coon42/FloppyOrgel/README.md

# FloppyOrgel
Collection of Software for the Floppy Orgel
