coon42/FloppyOrgel/Arduino/pcb/footprints/atmega328p-32tqfp.png

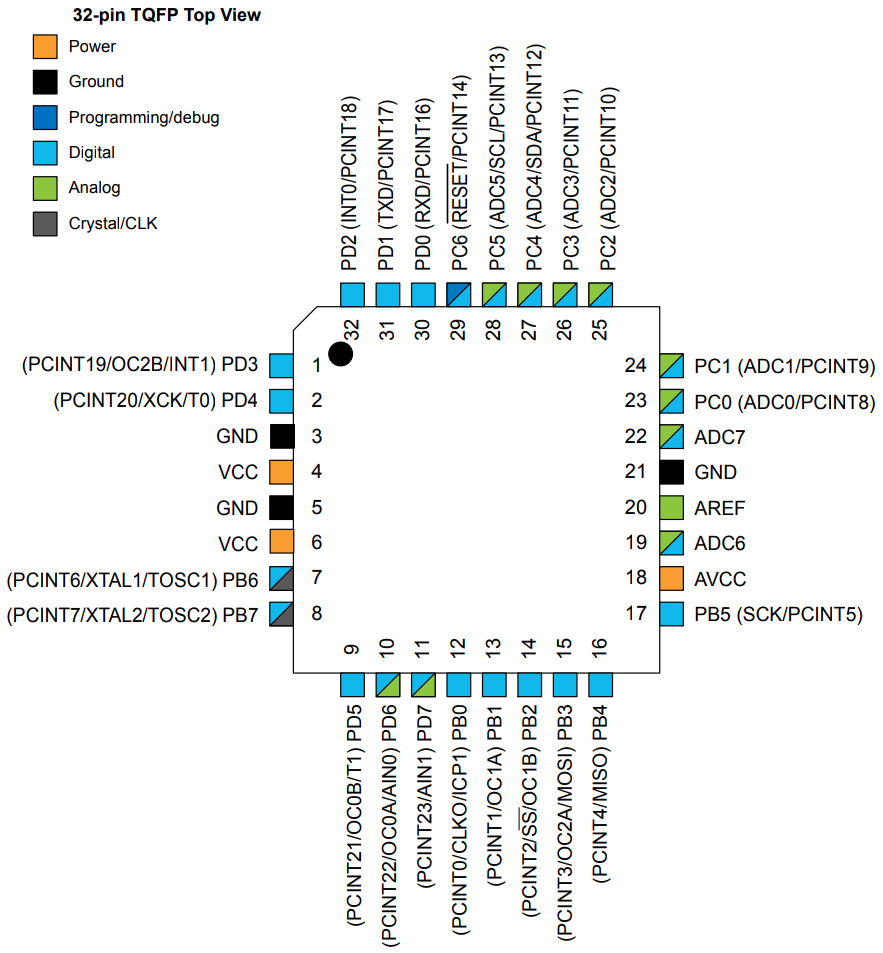
Arduino/pcb/footprints/atmega328p-32tqfp.png
