coon42/FloppyOrgel/(list of files, drawings)

Other design files:
Arduino/old_pcb/floppy_m0dule.PcbDoc
Arduino/old_pcb/floppy_m0dule.PcbLib
Arduino/old_pcb/floppy_m0dule.SchDoc
Arduino/old_pcb/floppy_m0dule.SchLib
Arduino/old_pcb/footprints.PcbLib
Arduino/old_pcb/open_step.PcbLib
Arduino/old_pcb/PCB_floppy_m0dule.PrjPCB
Arduino/pcb/floppy_m0dule.PcbDoc
Arduino/pcb/floppy_m0dule.PcbLib
Arduino/pcb/floppy_m0dule.SchDoc
Arduino/pcb/floppy_m0dule.SchLib
Arduino/pcb/footprints.PcbLib
Arduino/pcb/open_step.PcbLib
Arduino/pcb/PCB_floppy_m0dule.PrjPCB
