coon42/FloppyOrgel/Arduino/pcb/floppyorgel.kicad_pcb

## KiCad design Arduino/pcb/floppyorgel.kicad_pcb (2020-02-22)

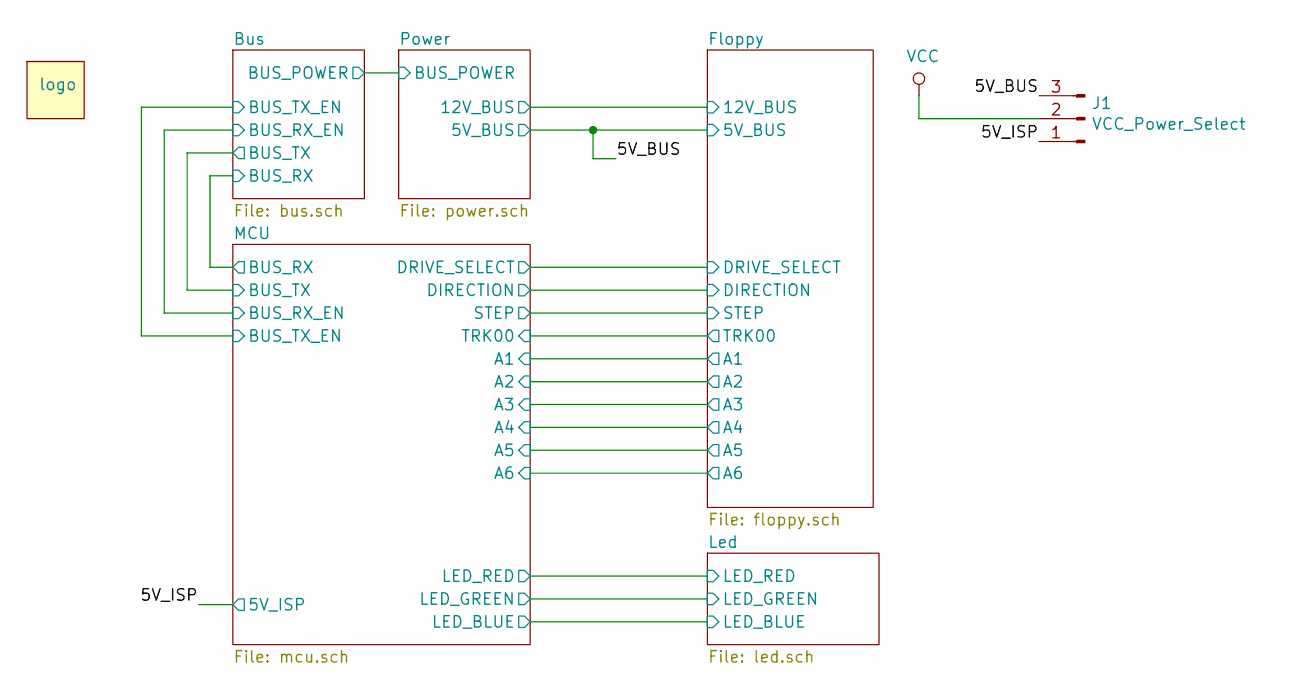
[picture p2: schematic floppyorgel.sch, Floppy Orgel]

Parts:
J1: VCC_Power_Select; switch_mmp122-r
L1: logo

Connections:
/5V_BUS: J1.3; also elsewhere on the board
/5V_ISP: J1.1; also elsewhere on the board
VCC: J1.2; also elsewhere on the board

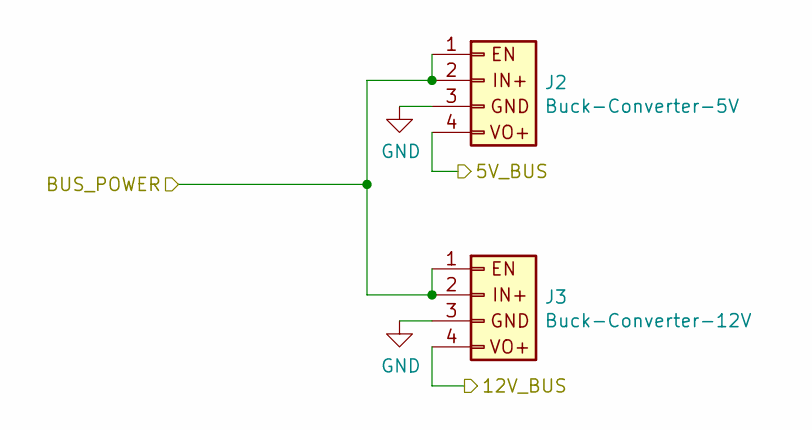
[picture p3: schematic power.sch]

Parts:
J2: Buck-Converter-5V; PinSocket_1x04_P2.54mm_Vertical
J3: Buck-Converter-12V; PinSocket_1x04_P2.54mm_Vertical

Connections:
/5V_BUS: J2.4; also elsewhere on the board
/Bus/BUS_POWER: J2.1, J2.2, J3.1, J3.2; also elsewhere on the board
/Floppy/12V_BUS: J3.4; also elsewhere on the board
GND: J2.3, J3.3; also elsewhere on the board

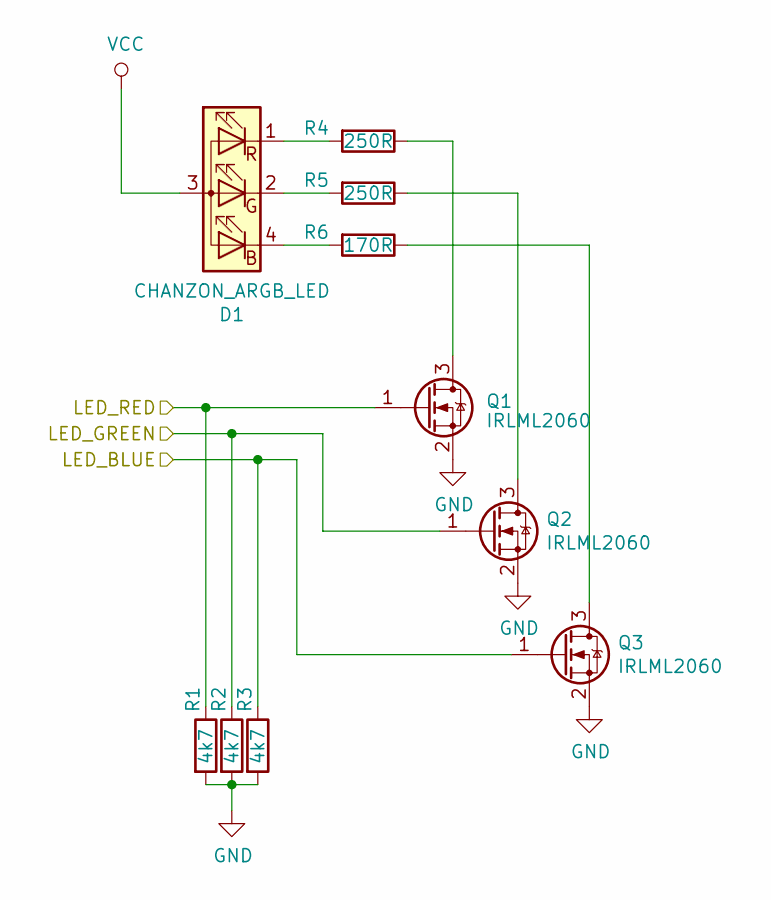
[picture p4: schematic led.sch]

Parts:
D1: CHANZON_ARGB_LED; rgb_led_0805_2012Metric
Q1, Q2, Q3: IRLML2060; SOT-23
R1, R2, R3: 4k7; R_0805_2012Metric
R4, R5: 250R; R_0805_2012Metric
R6: 170R; R_0805_2012Metric

Connections:
/Led/LED_BLUE: Q3.1 (G), R3.1; also elsewhere on the board
/Led/LED_GREEN: Q2.1 (G), R2.1; also elsewhere on the board
/Led/LED_RED: Q1.1 (G), R1.1; also elsewhere on the board
GND: Q1.2 (S), Q2.2 (S), Q3.2 (S), R1.2, R2.2, R3.2; also elsewhere on the board
unnamed: D1.1 (RK), R4.2
unnamed: D1.2 (GK), R5.2
unnamed: D1.4 (BK), R6.2
unnamed: Q1.3 (D), R4.1
unnamed: Q2.3 (D), R5.1
unnamed: Q3.3 (D), R6.1
VCC: D1.3 (COM); also elsewhere on the board

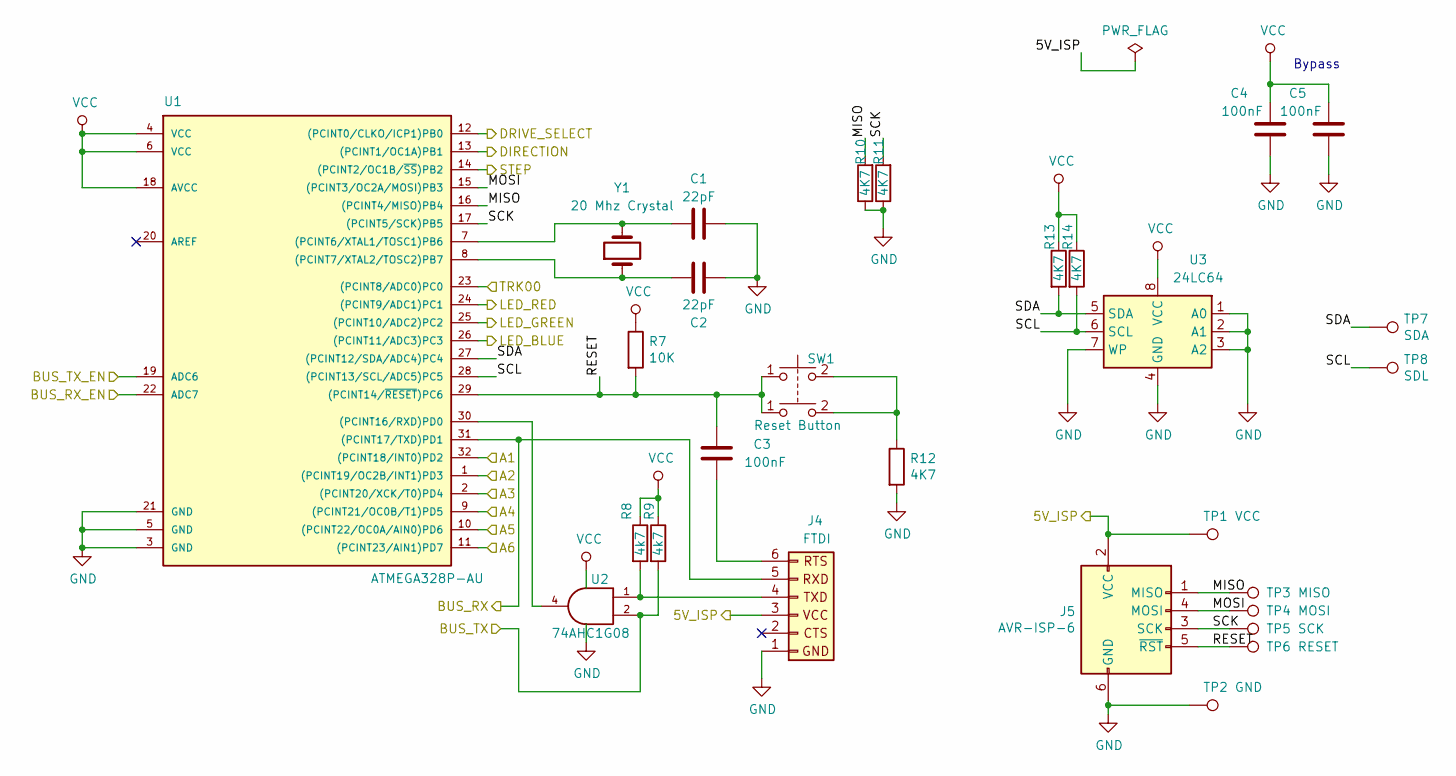
[picture p5: schematic mcu.sch]

Parts:
C1, C2: 22pF; C_0805_2012Metric
C3, C4, C5: 100nF; C_0805_2012Metric
J4: FTDI; PinHeader_1x06_P2.54mm_Vertical
J5: AVR-ISP-6; PinHeader_2x03_P2.54mm_Vertical
R7: 10K; R_0805_2012Metric
R8, R9: 4k7; R_0805_2012Metric
R10, R11, R12, R13, R14: 4K7; R_0805_2012Metric
SW1: Reset Button; SW_PUSH_6mm
TP1: VCC; TestPoint_Pad_D1.0mm
TP2: GND; TestPoint_Pad_D1.0mm
TP3: MISO; TestPoint_Pad_D1.0mm
TP4: MOSI; TestPoint_Pad_D1.0mm
TP5: SCK; TestPoint_Pad_D1.0mm
TP6: RESET; TestPoint_Pad_D1.0mm
TP7: SDA; TestPoint_Pad_D1.0mm
TP8: SDL; TestPoint_Pad_D1.0mm
U1: ATMEGA328P-AU; LQFP-32_7x7mm_P0.8mm
U2: 74AHC1G08; SOT-23-5
U3: 24LC64; TSSOP-8_4.4x3mm_P0.65mm
Y1: 20 Mhz Crystal; Crystal_HC49-4H_Vertical

Connections:
/5V_ISP: J4.3 (VCC), J5.2 (VCC), TP1.1; also elsewhere on the board
/Bus/BUS_RX: J4.5 (Receive), U1.31 ((PCINT17/TXD)PD1); also elsewhere on the board
/Bus/BUS_RX_EN: U1.22 (ADC7); also elsewhere on the board
/Bus/BUS_TX: R9.2, U2.2; also elsewhere on the board
/Bus/BUS_TX_EN: U1.19 (ADC6); also elsewhere on the board
/Floppy/A1: U1.32 ((PCINT18/INT0)PD2); also elsewhere on the board
/Floppy/A2: U1.1 ((PCINT19/OC2B/INT1)PD3); also elsewhere on the board
/Floppy/A3: U1.2 ((PCINT20/XCK/T0)PD4); also elsewhere on the board
/Floppy/A4: U1.9 ((PCINT21/OC0B/T1)PD5); also elsewhere on the board
/Floppy/A5: U1.10 ((PCINT22/OC0A/AIN0)PD6); also elsewhere on the board
/Floppy/A6: U1.11 ((PCINT23/AIN1)PD7); also elsewhere on the board
/Floppy/DIRECTION: U1.13 ((PCINT1/OC1A)PB1); also elsewhere on the board
/Floppy/DRIVE_SELECT: U1.12 ((PCINT0/CLKO/ICP1)PB0); also elsewhere on the board
/Floppy/STEP: U1.14 ((PCINT2/OC1B/~SS~)PB2); also elsewhere on the board
/Floppy/TRK00: U1.23 ((PCINT8/ADC0)PC0); also elsewhere on the board
/Led/LED_BLUE: U1.26 ((PCINT11/ADC3)PC3); also elsewhere on the board
/Led/LED_GREEN: U1.25 ((PCINT10/ADC2)PC2); also elsewhere on the board
/Led/LED_RED: U1.24 ((PCINT9/ADC1)PC1); also elsewhere on the board
/MCU/MISO: J5.1 (MISO), R10.2, TP3.1, U1.16 ((PCINT4/MISO)PB4)
/MCU/MOSI: J5.4 (MOSI), TP4.1, U1.15 ((PCINT3/OC2A/MOSI)PB3)
/MCU/RESET: C3.1, J5.5 (~RST), R7.2, SW1.1, TP6.1, U1.29 ((PCINT14/~RESET~)PC6)
/MCU/SCK: J5.3 (SCK), R11.2, TP5.1, U1.17 ((PCINT5/SCK)PB5)
/MCU/SCL: R14.2, TP8.1, U1.28 ((PCINT13/SCL/ADC5)PC5), U3.6 (SCL)
/MCU/SDA: R13.2, TP7.1, U1.27 ((PCINT12/SDA/ADC4)PC4), U3.5 (SDA)
GND: C1.2, C2.1, C4.2, C5.2, J4.1 (Ground), J5.6 (GND), R10.1, R11.1, R12.2, TP2.1, U1.3 (GND), U1.5 (GND), U1.21 (GND), U2.3 (GND), U3.1 (A0), U3.2 (A1), U3.3 (A2), U3.4 (GND), U3.7 (WP); also elsewhere on the board
unnamed: C1.1, U1.7 ((PCINT6/XTAL1/TOSC1)PB6), Y1.2
unnamed: C2.2, U1.8 ((PCINT7/XTAL2/TOSC2)PB7), Y1.1
unnamed: C3.2, J4.6 (Ready_to_send)
unnamed: J4.4 (Transmit), R8.2, U2.1
unnamed: R12.1, SW1.2
unnamed: U1.30 ((PCINT16/RXD)PD0), U2.4
VCC: C4.1, C5.1, R7.1, R8.1, R9.1, R13.1, R14.1, U1.4 (VCC), U1.6 (VCC), U1.18 (AVCC), U2.5 (VCC), U3.8 (VCC); also elsewhere on the board

Notes on the sheet:
Bypass

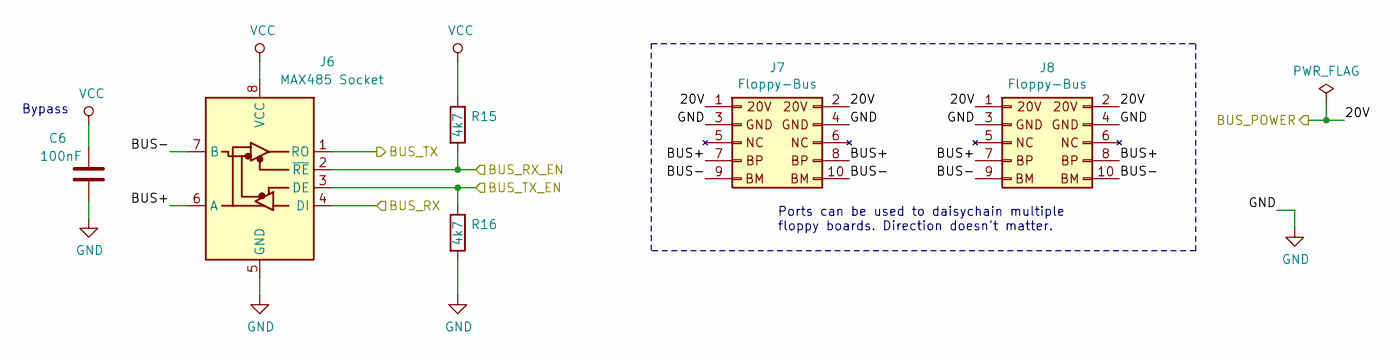
[picture p6: schematic bus.sch]

Parts:
C6: 100nF; C_0805_2012Metric
J6: MAX485 Socket; dil_8-300_socket
J7, J8: Floppy-Bus; Shrouded_Header_2x05_Pitch2.54mm
R15, R16: 4k7; R_0805_2012Metric

Connections:
/Bus/BUS+: J6.6 (A), J7.7 (BM), J7.8 (BM), J8.7 (BM), J8.8 (BM)
/Bus/BUS-: J6.7 (B), J7.9, J7.10, J8.9, J8.10
/Bus/BUS_POWER: J7.1 (20V), J7.2 (20V), J8.1 (20V), J8.2 (20V); also elsewhere on the board
/Bus/BUS_RX: J6.4 (DI); also elsewhere on the board
/Bus/BUS_RX_EN: J6.2 (~RE), R15.2; also elsewhere on the board
/Bus/BUS_TX: J6.1 (RO); also elsewhere on the board
/Bus/BUS_TX_EN: J6.3 (DE), R16.1; also elsewhere on the board
GND: C6.2, J6.5 (GND), J7.3 (GND), J7.4 (GND), J8.3 (GND), J8.4 (GND), R16.2; also elsewhere on the board
VCC: C6.1, J6.8 (VCC), R15.1; also elsewhere on the board

Notes on the sheet:
Bypass
Ports can be used to daisychain multiple floppy boards. Direction doesn't matter.

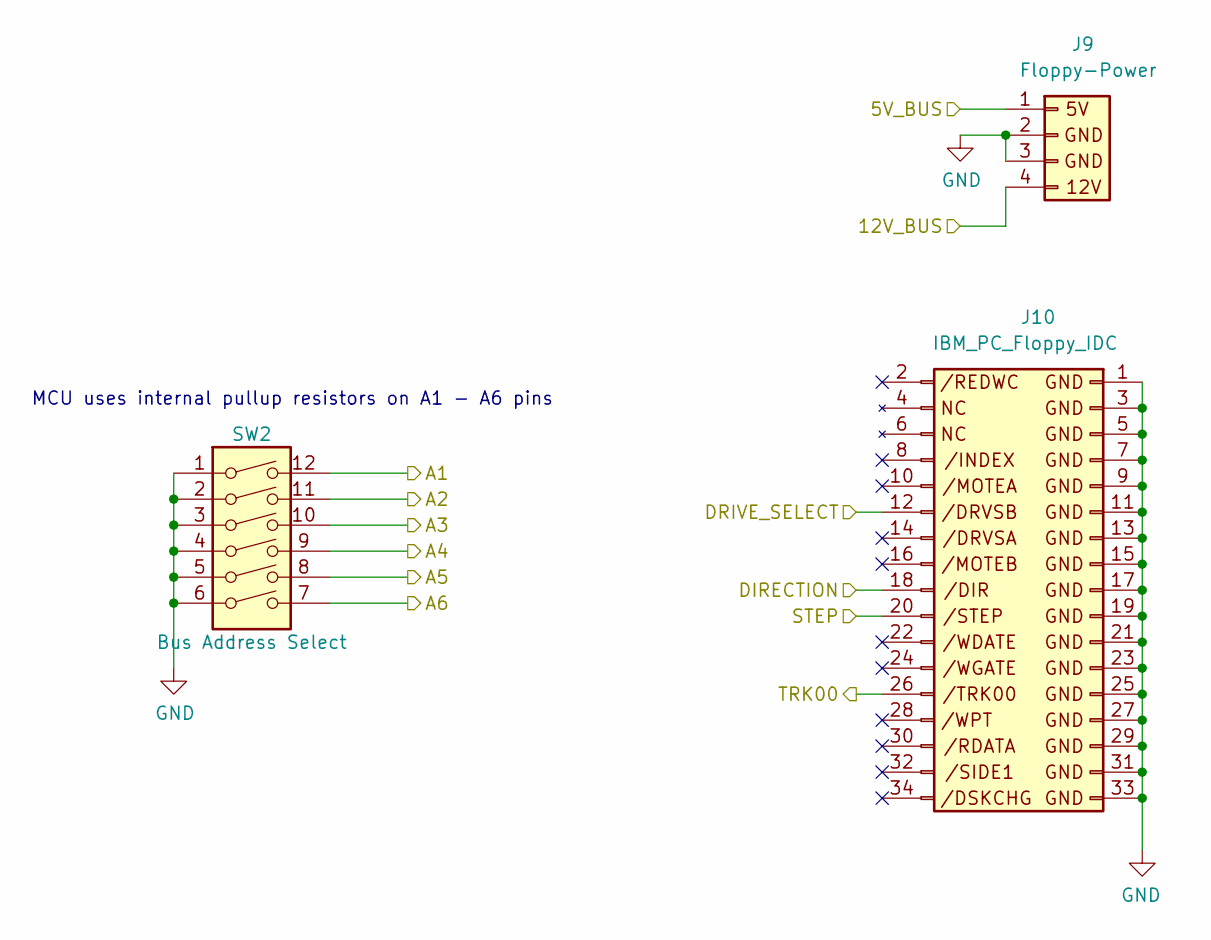
[picture p7: schematic floppy.sch]

Parts:
J9: Floppy-Power; Floppy_Power_1x04_Pitch2.54mm
J10: IBM_PC_Floppy_IDC; ibm_pc_floppy_idc
SW2: Bus Address Select; SW_DIP_SPSTx06_Slide_9.78x17.42mm_W7.62mm_P2.54mm

Connections:
/5V_BUS: J9.1 (5V); also elsewhere on the board
/Floppy/12V_BUS: J9.4 (12V); also elsewhere on the board
/Floppy/A1: SW2.12; also elsewhere on the board
/Floppy/A2: SW2.11; also elsewhere on the board
/Floppy/A3: SW2.10; also elsewhere on the board
/Floppy/A4: SW2.9; also elsewhere on the board
/Floppy/A5: SW2.8; also elsewhere on the board
/Floppy/A6: SW2.7; also elsewhere on the board
/Floppy/DIRECTION: J10.18; also elsewhere on the board
/Floppy/DRIVE_SELECT: J10.12; also elsewhere on the board
/Floppy/STEP: J10.20; also elsewhere on the board
/Floppy/TRK00: J10.26; also elsewhere on the board
GND: J9.2 (Ground), J9.3 (Ground), J10.1, J10.3, J10.5, J10.7, J10.9, J10.11, J10.13, J10.15, J10.17, J10.19, J10.21, J10.23, J10.25, J10.27, J10.29, J10.31, J10.33, SW2.1, SW2.2, SW2.3, SW2.4, SW2.5, SW2.6; also elsewhere on the board

Notes on the sheet:
MCU uses internal pullup resistors on A1 - A6 pins

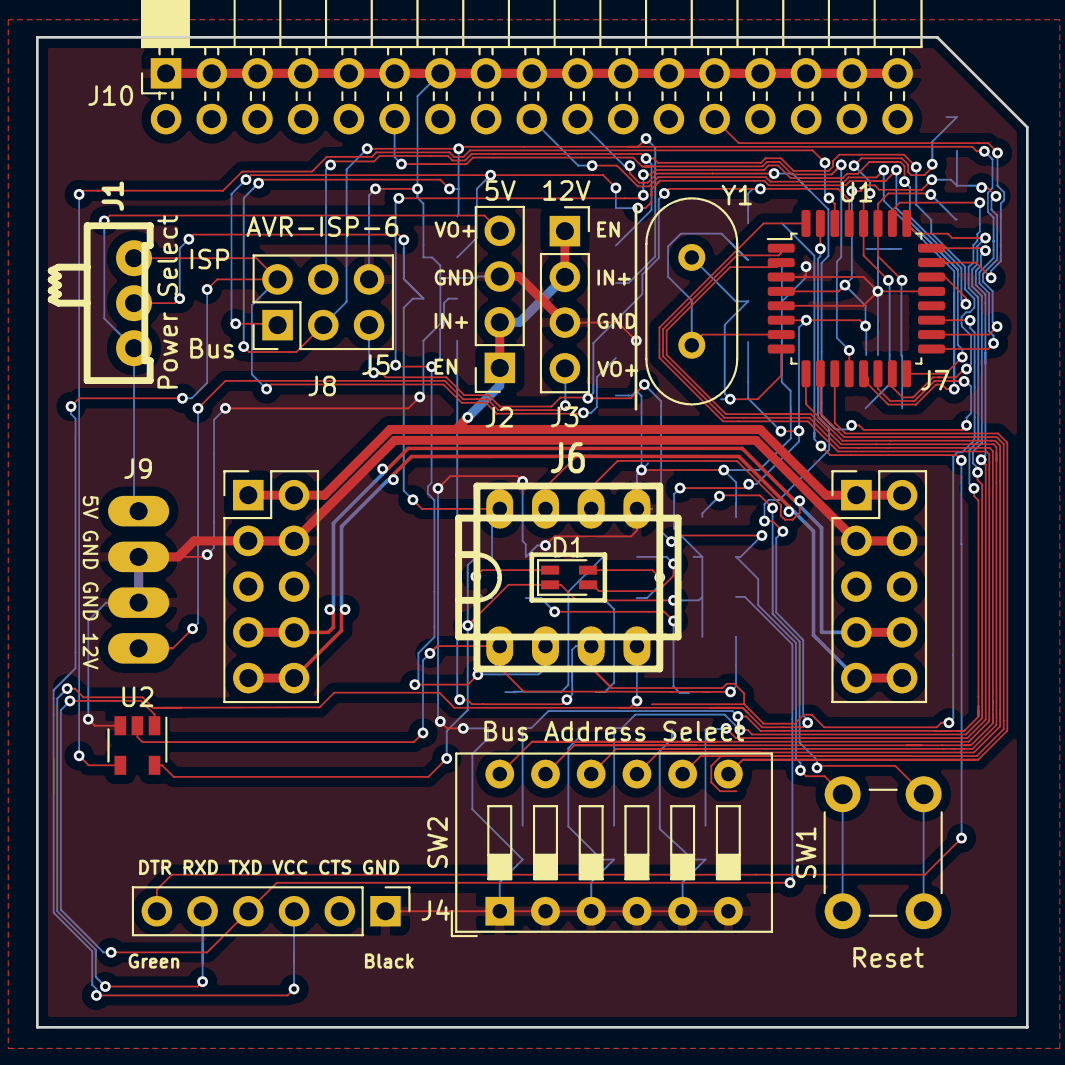
[picture p8: board floppyorgel.kicad_pcb from above]

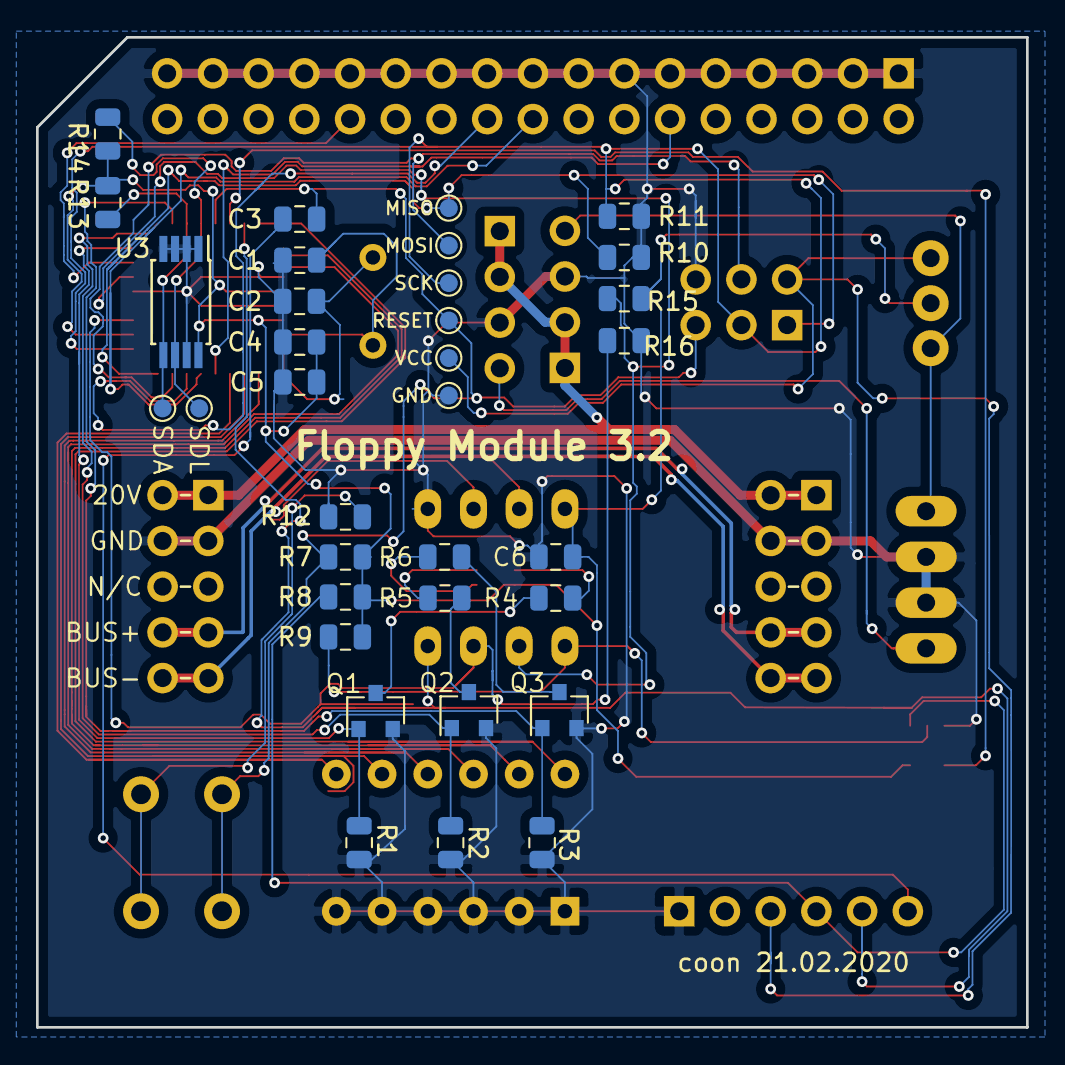
[picture p9: board floppyorgel.kicad_pcb from below]

Board: 2 copper layers, 55.0 x 55.0 mm, 51 parts (35 on the bottom side), 43 nets.
