coon42/FloppyOrgel/(commit log)

2018-05-26 add FlyFi submodule + arduino firmware
    [PCB_floppy_m0dule.PrjPCB, floppy_m0dule.PcbDoc, floppy_m0dule.PcbLib, floppy_m0dule.SchDoc, floppy_m0dule.SchLib, footprints.PcbLib, open_step.PcbLib]
2018-05-26 use proper subdirectory for arduino project
2018-06-25 Arduino: add provisional bassdrive sketch
2018-06-28 rename: pcb -> old_pcb
    [PCB_floppy_m0dule.PrjPCB, floppy_m0dule.PcbDoc, floppy_m0dule.PcbLib, floppy_m0dule.SchDoc, floppy_m0dule.SchLib, footprints.PcbLib, open_step.PcbLib]
2018-06-28 arduino: do not turn on first led on boot
2018-06-28 arduino: add missing file for bassdrive
    [FloppyM0dule.cpp, FloppyM0dule.h, FloppyM0dule_conf.h]
2018-07-04 pcb: add floppy_power footprint
2018-07-04 pcb: update
    [_saved_floppyorgel.sch, floppyorgel.kicad_pcb, floppyorgel.sch]
2019-02-24 pcb: add footprints subdir with some parts
2019-02-24 pcb: remove .bak files
2019-02-24 pcb: add 3d subdir
2019-02-24 pcb: add sym-lib-table
2019-02-24 pcb: add shrouded.pretty
2019-02-24 pcb: move floppy power footprint
2019-02-24 pcb: add floppy-power part
2019-02-24 pcb: add ibm_pc_floppy_idc part
2019-02-24 pcb: use new parts
    [floppyorgel.sch]
2019-02-24 pcb: remove _saved_floppyorgel.sch
    [_saved_floppyorgel.sch]
2019-02-24 pcb: fix footprint paths
    [floppyorgel.sch]
2019-04-21 floppyorgel.sch: do some routing
    [floppyorgel.sch]
2019-04-21 floppyorgel.sch: auto fix of error
    [floppyorgel.sch]
2019-04-22 floppyorgel.sch: continue wiring up
    [floppyorgel.sch]
2019-04-22 floppyorgel.sch: auto fix of error again
    [floppyorgel.sch]
2019-04-22 floppyorgel.sch: wiring shift registers
    [floppyorgel.sch]
2019-04-22 floppyorgel.sch: wiring reset circuit
    [floppyorgel.sch]
2019-04-22 floppyorgel.sch: auto repair
    [floppyorgel.sch]
2019-04-22 floppyorgel.sch: add bypass caps
    [floppyorgel.sch]
2019-04-22 floppyorgel.sch: add hierachical sheets
    [bus.sch, floppy.sch, floppyorgel.sch, led.sch, mcu.sch, power.sch]
2019-04-22 floppyorgel.sch: reduce ERC errors
    [floppyorgel.sch]
2019-04-23 pcb: add vcc power select footprint
2019-04-23 pcb: continue wiring / move parts to hierachival sheets
    [bus.sch, floppy.sch, floppyorgel.sch, led.sch, mcu.sch, power.sch]
2019-04-27 pcb: finish wiring / use ws2812 under chip led
    [bus.sch, floppy.sch, floppyorgel.sch, led.sch, mcu.sch, power.sch]
2019-04-27 pcb: assign footprints
    [bus.sch, floppy.sch, floppyorgel.sch, led.sch, mcu.sch, power.sch]
2019-05-03 pcb: add I2C eeprom
    [floppy.sch, floppyorgel.kicad_pcb, led.sch, mcu.sch, power.sch]
2019-05-03 pcb: finished part placement
    [floppyorgel.kicad_pcb]
2019-05-04 pcb: add SOIC-8 socket footprint + 3D model
    [bus.sch, floppyorgel.kicad_pcb]
2019-05-05 pcb: continue placement + add some info on silk
    [bus.sch, floppy.sch, floppyorgel.kicad_pcb, floppyorgel.sch, led.sch, mcu.sch]
2019-05-08 pcb: add testpads for SPI
    [floppyorgel.kicad_pcb, mcu.sch]
2019-05-10 pcb: add testpads for I2C
    [floppyorgel.kicad_pcb, mcu.sch]
2019-05-11 pcb: fix bus wiring, add bus silk pin descriptions
    [bus.sch, floppyorgel.kicad_pcb]
2019-05-17 pcb: add logo and zones
    [floppyorgel.kicad_pcb]
2019-05-17 pcb: add led series resistors to rgb led
    [led.sch]
2019-05-18 pcb: add missing footprints / add component for logo footprint
    [bus.sch, floppyorgel.kicad_pcb, led.sch, mcu.sch]
2019-05-18 pcb: fix logo library
    [bus.sch, floppy.sch, floppyorgel.sch, led.sch, mcu.sch, power.sch]
2019-05-18 pcb: add customized footprint for floppy connector
2019-05-18 pcb: fix FTDI and floppy connector orientation
    [bus.sch, floppy.sch, floppyorgel.kicad_pcb, floppyorgel.sch, led.sch, mcu.sch, power.sch]
2019-05-18 pcb: add 'ThinkPad' font
2019-05-18 pcb: add mosfets to RGB led
    [floppyorgel.kicad_pcb, led.sch]
2019-05-23 pcb: add footprint for RGB led
    [floppyorgel.kicad_pcb, led.sch]
2019-06-01 pcb: add switch for VCC power select
    [bus.sch, floppyorgel.kicad_pcb, floppyorgel.sch, led.sch, mcu.sch]
2019-06-01 pcb: add footprint + 3D model for switch
2019-06-01 pcb: cut floppy edge + beautification
    [floppyorgel.kicad_pcb]
2019-06-03 pcb: some routing
    [floppyorgel.kicad_pcb, mcu.sch]
2019-06-04 pcb: add rgb_led symbol
2019-06-04 pcb: fix rgb led footprint
    [floppyorgel.kicad_pcb, led.sch]
2019-06-04 pcb: add rgb led datasheet
    [led.sch]
2019-07-17 pcb: finished routing
    [floppyorgel.kicad_pcb]
2019-08-11 pcb: minor adjustments in silkscreen
    [floppyorgel.kicad_pcb, mcu.sch]
2019-08-18 pcb: further adjustments in silkscreen
    [floppyorgel.kicad_pcb]
2019-08-29 pcb: swap red and blue pin on RGB led
    [bus.sch, floppy.sch, floppyorgel.kicad_pcb, floppyorgel.sch, led.sch, mcu.sch, power.sch]
2019-09-10 pcb: mcu: add image for 328p TQFP pinout
    [mcu.sch]
2019-09-10 pcb: mcu: add and route I2C pull up resistors
    [floppyorgel.kicad_pcb, mcu.sch]
2019-10-02 firmware: add firmware for revision 3.x boards
2019-10-02 pcb: use OR gate between FTDI and RS485 TX lines
    [floppyorgel.kicad_pcb, mcu.sch]
2019-10-02 pcb: bus: more descriptive text for bus connectors
    [bus.sch]
2019-10-03 pcb: mcu: replace OR by AND gate / use pullups on TX pins
    [floppyorgel.kicad_pcb, mcu.sch]
2019-10-03 pcb: mcu / bus: improve TX/RX labels for RS485 transceiver
    [bus.sch, floppyorgel.sch, mcu.sch]
2019-10-04 pcb: did... something
    [floppy.sch, floppyorgel.kicad_pcb, led.sch, mcu.sch]
2019-10-05 pcb / floppy: remove 4094 shift register / connect address connector directly
    [floppy.sch, floppyorgel.kicad_pcb, floppyorgel.sch, led.sch, mcu.sch]
2019-10-05 pcb / led: remove hc595 shift register / connect led directly
    [floppyorgel.kicad_pcb, floppyorgel.sch, led.sch, mcu.sch]
2019-10-10 pcb: route RS485 control pins
    [bus.sch, floppy.sch, floppyorgel.kicad_pcb, floppyorgel.sch, led.sch, mcu.sch, power.sch]
2019-10-16 pcb: do some final optimizations for v3.1
    [floppyorgel.kicad_pcb, mcu.sch]
2020-02-15 migrate to kicad 5.x
    [bus.sch, floppy.sch, floppyorgel.sch, led.sch, mcu.sch, power.sch]
2020-02-15 pcb: increase board dimensions by 5x5mm + delete all tracks
    [floppyorgel.kicad_pcb]
2020-02-16 pcb: ajdust design rules (via size)
2020-02-16 pcb: begin routing for v3.2
    [floppyorgel.kicad_pcb]
2020-02-17 pcb: rename RS485 bus pins + differential pair routing
    [bus.sch, floppyorgel.kicad_pcb]
2020-02-18 pcb: more routing...
    [floppyorgel.kicad_pcb]
2020-02-21 pcb: continue routing
    [floppyorgel.kicad_pcb]
2020-02-21 pcb: finish routing of v3.2
    [floppyorgel.kicad_pcb]
2020-02-21 pcb: reannotate symbols
    [bus.sch, floppy.sch, led.sch, mcu.sch, power.sch]
2020-02-22 fix routing with v3.2 with updated annotations
    [floppyorgel.kicad_pcb]
2022-05-26 fix footprints
